sourcebots/Pi-Powerboard-hw/README.md

# Pi-Powerboard-hw
Design for powering raspberry pi through GPIO

Schematic
