sourcebots/Pi-Powerboard-hw/pi_power_board.kicad_pcb

## KiCad design pi_power_board.kicad_pcb (2019-07-15)

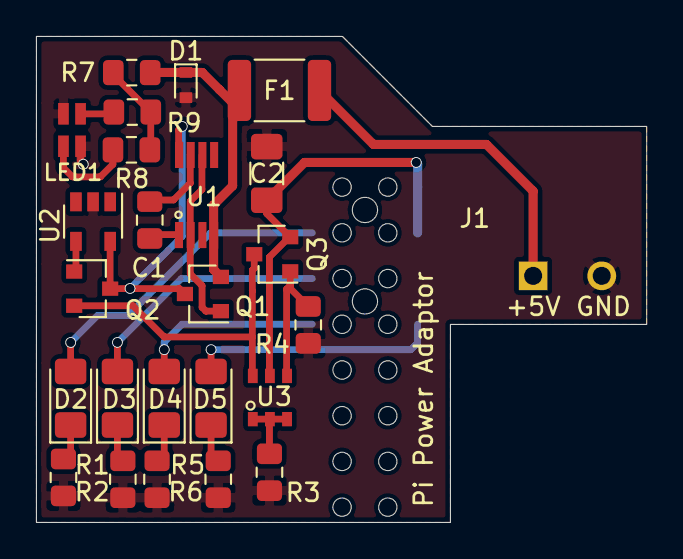
[picture p1: board pi_power_board.kicad_pcb from above]

Board: 2 copper layers, 33.9 x 27.0 mm, 26 parts (0 on the bottom side), 23 nets.

Parts:
C1: 2.2u; C_0805_2012Metric_Pad1.15x1.40mm_HandSolder
C2: 4.7u; C_1206_3216Metric_Pad1.42x1.75mm_HandSolder
D1: ESDA18-1K; D_SOD-523
D2: IN-S126ATYR; LED_1206_3216Metric_Pad1.42x1.75mm_HandSolder
D3: IN-S126ATY; LED_1206_3216Metric_Pad1.42x1.75mm_HandSolder
D4, D5: IN-S126ATG; LED_1206_3216Metric_Pad1.42x1.75mm_HandSolder
F1: MF-MSMF200-2; Fuse_1812_4532Metric_Pad1.30x3.40mm_HandSolder
J1: 381camcon
J2: Conn_02x04_Odd_Even; BG120-08-A-0-N-D
LED1: APHBM2012
Q1, Q2: SSM3K335R; SOT-23
Q3: DMG2305UX-7; SOT-23
R1, R2, R5, R6: 82; R_0805_2012Metric_Pad1.15x1.40mm_HandSolder
R3: 10k; R_0805_2012Metric_Pad1.15x1.40mm_HandSolder
R4: 47k; R_0805_2012Metric_Pad1.15x1.40mm_HandSolder
R7: 470; R_0805_2012Metric_Pad1.15x1.40mm_HandSolder
R8, R9: 0; R_0805_2012Metric_Pad1.15x1.40mm_HandSolder
U1: LM74610
U2: TPS2400; SOT-23-5
U3: DMMT5401

Connections:
+5V: C2.2, J2.2, J2.4, Q3.2, U3.5
+VDC: D1.1, F1.1, Q1.2, R7.2, U1.4
GND: C2.1, D1.2, J1.2, J2.6, LED1.1, LED1.3, R1.2, R2.2, R3.2, R4.2, R5.2, R6.2, U2.2
unnamed: C1.1, U1.7
unnamed: C1.2, U1.1
unnamed: D2.1, R1.1
unnamed: D2.2, J2.3
unnamed: D3.1, R2.1
unnamed: D3.2, J2.5
unnamed: D4.1, R5.1
unnamed: D4.2, J2.7
unnamed: D5.1, R6.1
unnamed: D5.2, J2.8
unnamed: F1.2, J1.1
unnamed: LED1.2, R8.1
unnamed: LED1.4, R9.2
unnamed: Q1.1, U1.2, U1.6
unnamed: Q1.3, Q2.3, U1.8, U2.5
unnamed: Q2.1, U2.4
unnamed: Q2.2, Q3.3, U3.6
unnamed: Q3.1, R4.1, U3.4
unnamed: R3.1, U3.1, U3.2, U3.3
unnamed: R7.1, R8.2, R9.1
