sourcebots/Pi-Powerboard-hw/(threads)

Thread 1 (2019-07-28):

Missing Licensing

trickeydan, 2019-07-28:

jcwilliamson, 2021-11-29:
@trickeydan @Tyler-Ward @kierdavis @WillB97 I have created a pull request to license this under CC0 public domain license. However, as you all contributed, I would like to have your opinions before we go ahead.

trickeydan, 2021-11-30:
I am not sure that I materially contributed to this project, but I am happy for CC0 if you think I did.

Tyler-Ward, 2021-12-04:
CC0 is fine with me

WillB97, 2021-12-05:
LGTM

kierdavis, 2021-12-05:
CC0 works for me!

Thread 2 (2019-08-12):

Serial pins are blocked

trickeydan, 2019-08-12:
This makes debugging more difficult, and also means that one of the LEDs does not work as intended.

@kierdavis please could you write some more details

kierdavis, 2019-08-13:
Pin 8 on the raspberry pi header is the serial transmit pin; however it is connected to a GPIO LED. You can't plug in a USB-to-serial cable while this hat is connected, which makes debugging a bit tricky.

I think we should rearrange the pinout to put the LED on a different pin e.g. 11. Even better, we could put a USB-to-serial chip and USB connector on the board itself.

Thread 5 (2019-08-19):

Power input connections don't match the other boards we use

kierdavis, 2019-08-19:
The SR power, motor and servo boards follow a convention of having the left-hand terminal of a camcon socket be the positive connection and the right-hand terminal be the negative connection (when said socket is viewed head-on). The terminals of the power hat's input camcon contradict this convention, which may lead to confusion among users.
