sourcebots/Pi-Powerboard-hw/(commit log)

2019-06-10 Upload of design and libraries
    [pi_power_board.kicad_pcb, pi_power_board.sch]
2019-06-11 fixed issue with board edges
2019-06-26 Change header to SMT W/through holes
    [pi_power_board.kicad_pcb, pi_power_board.sch]
2019-07-15 Added Details to schematic border
    [pi_power_board.sch]
2019-07-15 Manufacturability changes and dimension fixing
    [pi_power_board.kicad_pcb]
2019-07-15 Added page frame data
    [pi_power_board.kicad_pcb]
2019-07-15 Updated Master component footprint
2019-07-15 DRC fixes
    [pi_power_board.kicad_pcb]
2019-07-15 Updated camcon hole size
    [pi_power_board.kicad_pcb]
2019-11-23 Added schematic to README as svg
